alexxpeng/Anatidae60/README.md

# Anatidae60
 Custom 60%Keyboard Atmega32u4

 QMK Firmware Steps
 Linux VM -> clone qmk-firmware
 make new directory under /keyboards
 edit config.h, KEYBNAME.h, keymap/default/keymap.c

 qmk compile
 send .hex to windows
 run qmk toolbox with .hex
