alexxpeng/Anatidae60/QmkfirmwareFiles/readme.md

# Anatidae60

Designed by Arct2ruS
 
* Hardware Supported: ATMega32u4
* Hardware Availability: N/A (private board, might open source)
