alexxpeng/Anatidae60/Keebrov2/wip1.docx

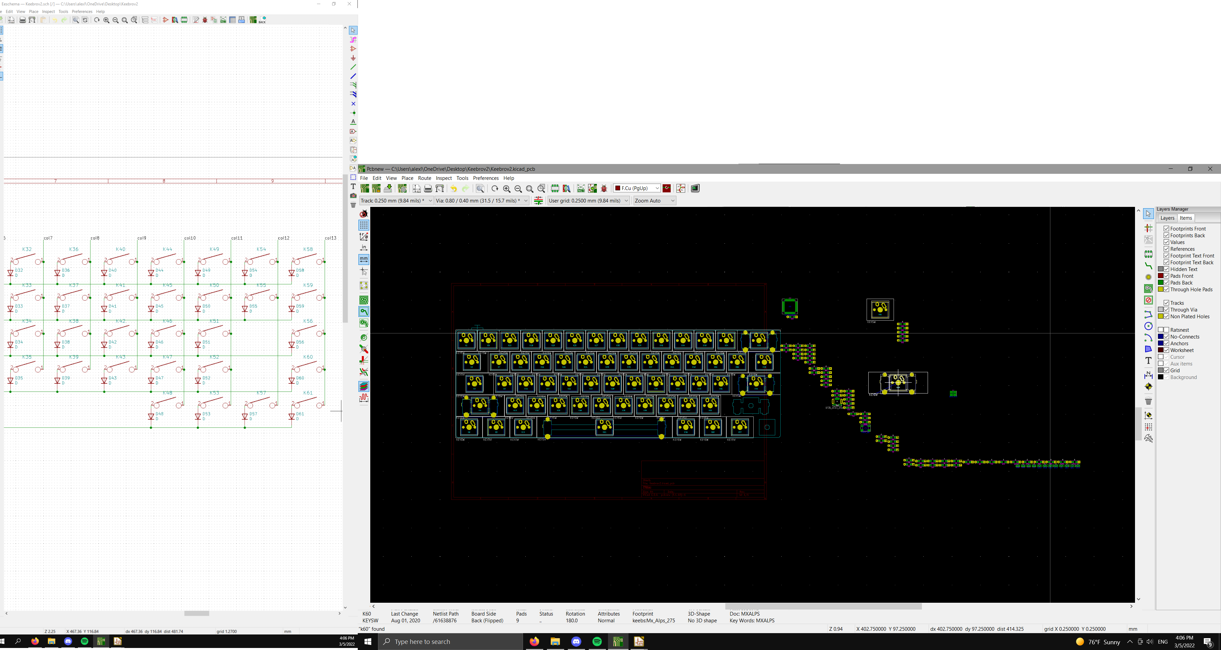
[picture p1: figure]
