alexxpeng/Anatidae60/Keebrov2/duck.png

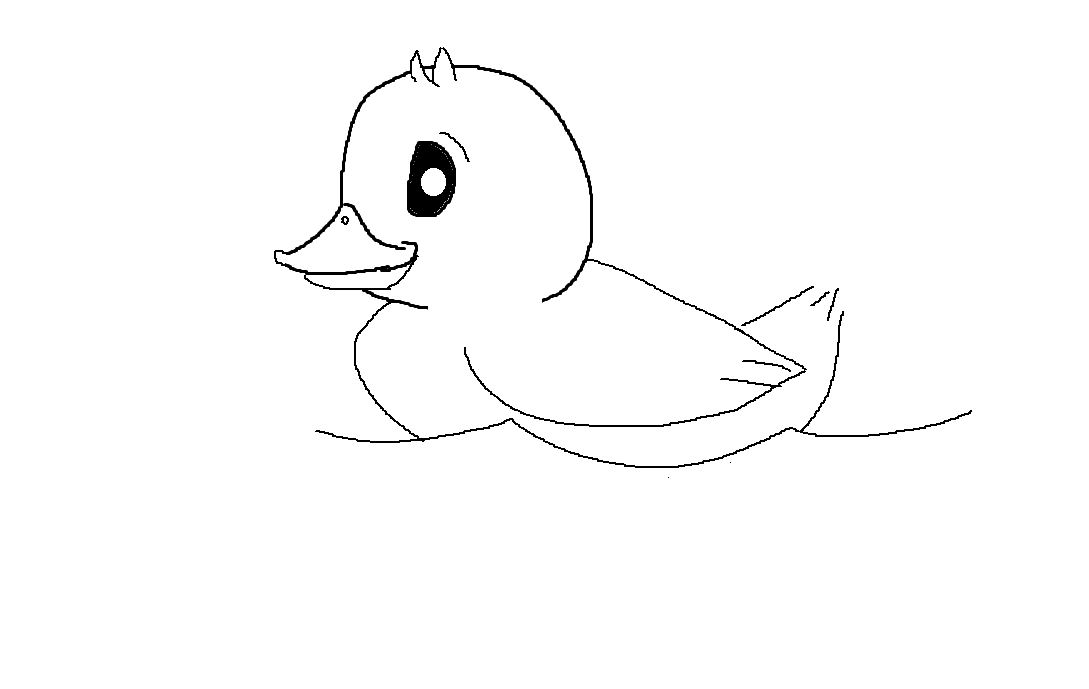
Keebrov2/duck.png
