alexxpeng/Anatidae60/Anatidae60NWeight/Anatidae60 v9.stl

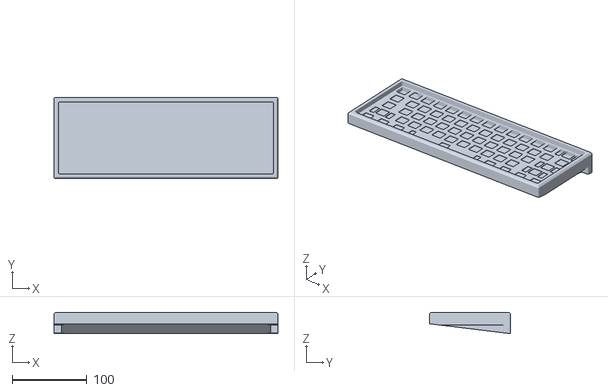
[picture p3: CAD file, 2022-03-24]
Anatidae60NWeight/Anatidae60 v9.stl
298.7 x 108.2 x 28.5
