alexxpeng/Anatidae60/Anatidae60Weight/BottomCase.step

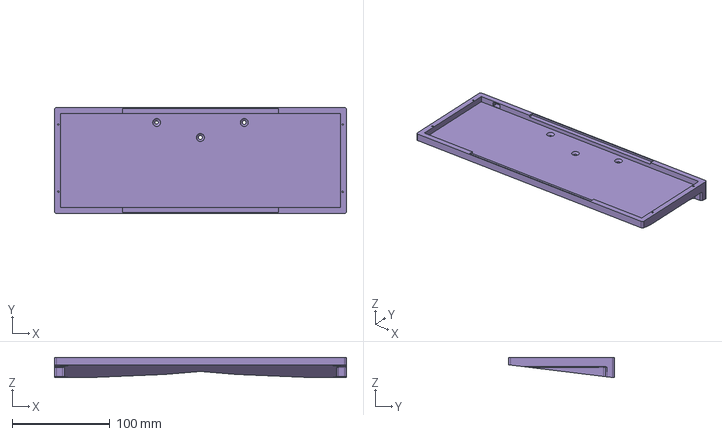
[picture p4: CAD file, 2022-04-01]
Anatidae60Weight/BottomCase.step
298.7 x 108.2 x 21.0 mm
