alexxpeng/Anatidae60/generic60.dxf

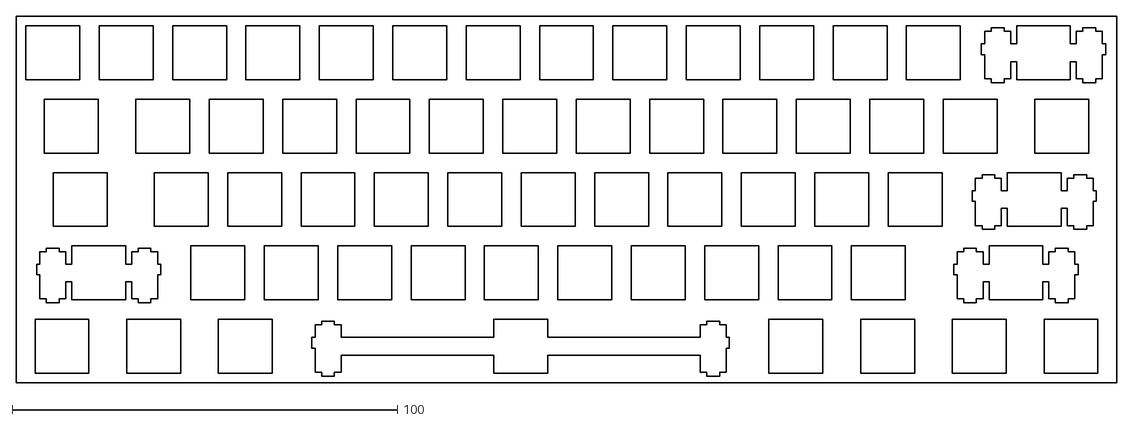
[picture p5: CAD file, 2022-03-24]
generic60.dxf
285.7 x 95.2
