alexxpeng/Anatidae60/Anatidae60NWeight/Anatidae60Top0.1.stl

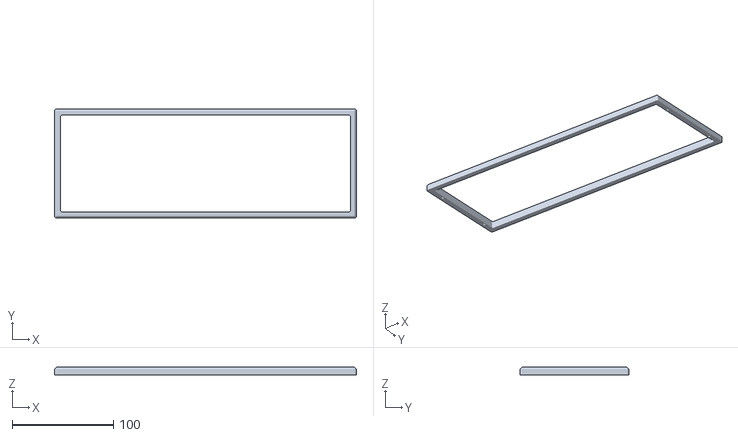
[picture p6: CAD file, 2022-03-24]
Anatidae60NWeight/Anatidae60Top0.1.stl
298.7 x 108.2 x 7.50
