alexxpeng/Anatidae60/Anatidae60Weight/Weight.step

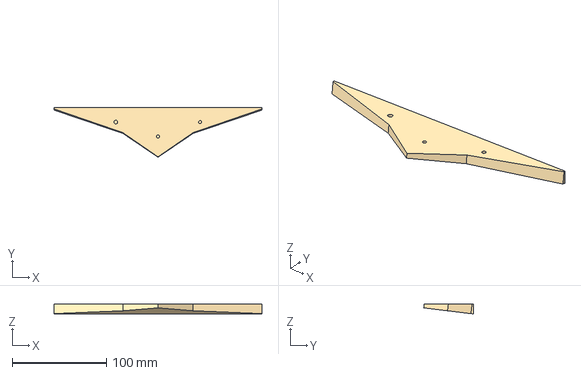
[picture p7: CAD file, 2022-04-01]
Anatidae60Weight/Weight.step
221.0 x 52.6 x 10.5 mm
