alexxpeng/Anatidae60/Anatidae60Weight/Plate.step

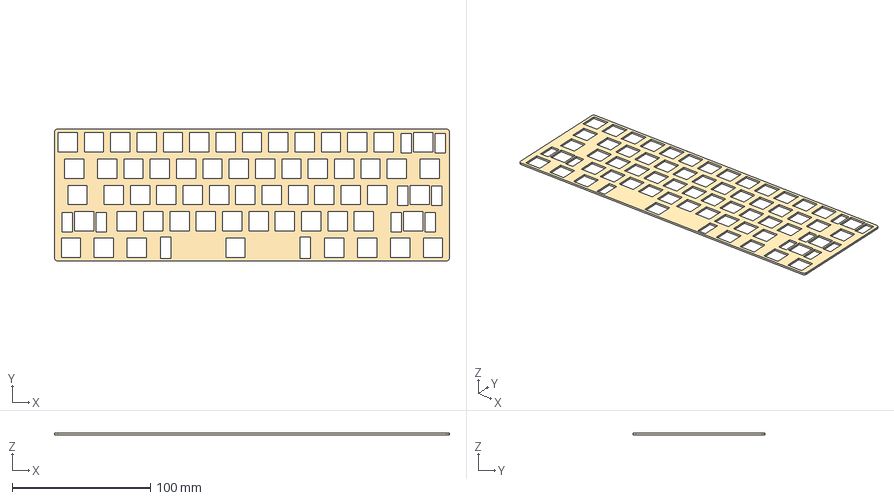
[picture p8: CAD file, 2022-04-01]
Anatidae60Weight/Plate.step
285.7 x 95.2 x 1.50 mm
