alexxpeng/Anatidae60/Anatidae60NWeight/Anatidae60Bot0.1.stl

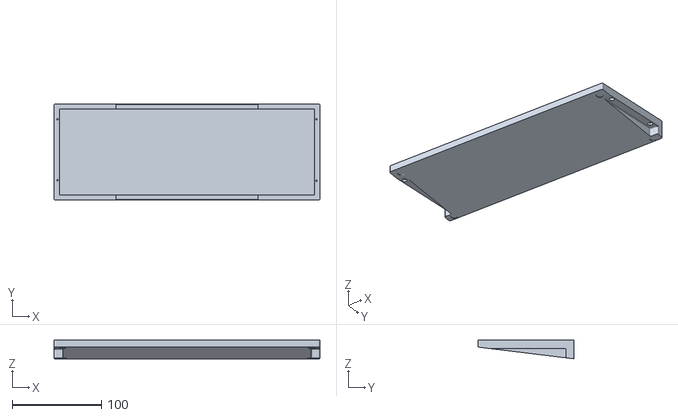
[picture p9: CAD file, 2022-03-24]
Anatidae60NWeight/Anatidae60Bot0.1.stl
298.7 x 108.2 x 21.0
