alexxpeng/Anatidae60/Anatidae60Weight/Anatidae60 v12.step

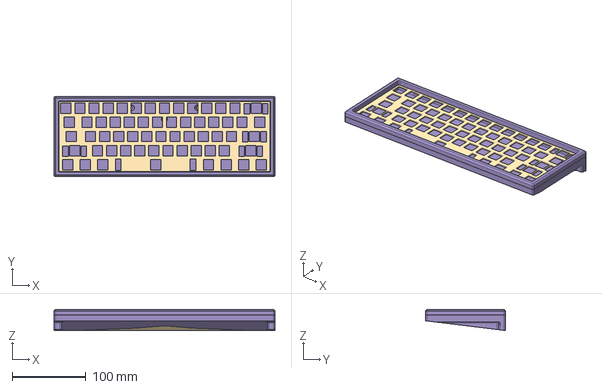
[picture p10: CAD file, 2022-03-24]
Anatidae60Weight/Anatidae60 v12.step
298.7 x 108.2 x 28.5 mm
