alexxpeng/Anatidae60/Anatidae60Weight/Anatidae60 v11.dxf

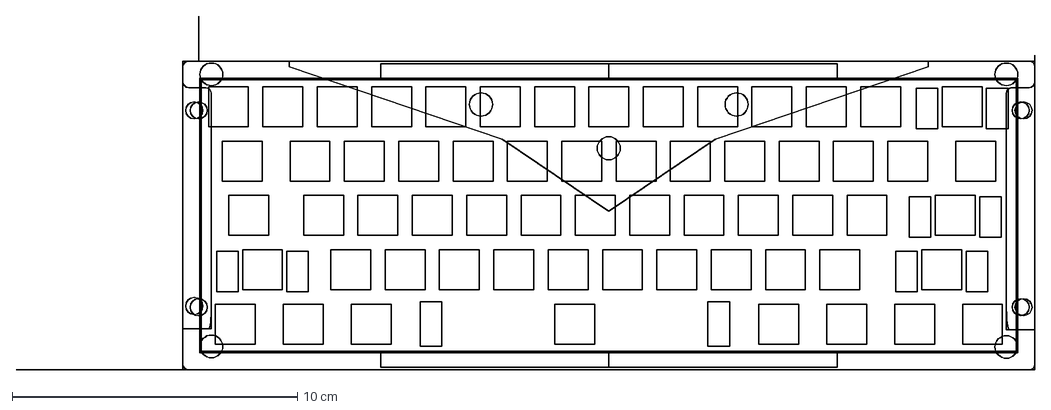
[picture p11: CAD file, 2022-03-24]
Anatidae60Weight/Anatidae60 v11.dxf
35.7 x 12.4 cm
