alexxpeng/Anatidae60/(list of files, cad)

Other CAD files:
Anatidae60NWeight/Anatidae60 v0.1.step
Anatidae60NWeight/Anatidae60plate0.1.stl
Anatidae60Weight/TopCase.step
Anatidae60Weight/Anatidae60Weight.stl
Anatidae60Weight/Anatidae60Plate.stl
Anatidae60Weight/Anatidae60Bot.stl
Anatidae60Weight/Anatidae60Top.stl
Anatidae60NWeight/Anatidae60 v9.f3d
Anatidae60Weight/Anatidae60 v11.f3d
Anatidae60Weight/Anatidae60 v12.stl
